adolfo-univasf/SensorBeeCounter/README.md

# SensorBeeCounter
Sensor desenvolvido para monitorar a entrada e saída de abelhas em colmeias, com o objetivo de avaliar a polinização em culturas como a manga com maior precisão.
