adolfo-univasf/SensorBeeCounter/firmware/Sensor_Firmware/Main_SensorCaixa/Esquema do prototipo.png

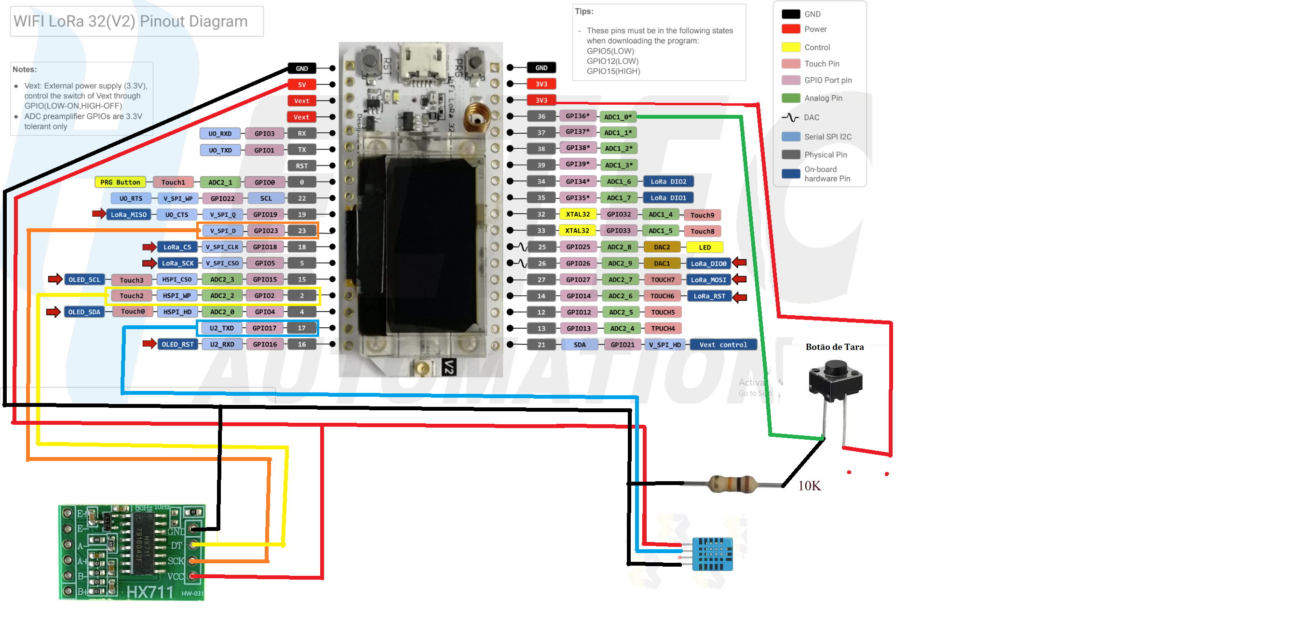
firmware/Sensor_Firmware/Main_SensorCaixa/Esquema do prototipo.png
