adolfo-univasf/SensorBeeCounter/3D_Project/Caixa Eletronica/caixa_Eletronica_KIT.FCStd

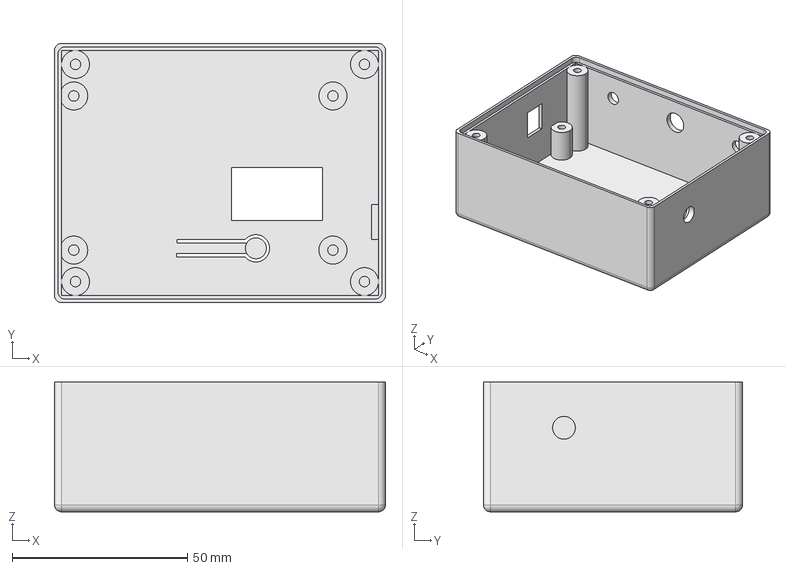
[picture p9: CAD file, 2026-01-25]
3D_Project/Caixa Eletronica/caixa_Eletronica_KIT.FCStd
94.5 x 74.0 x 37.0 mm
