adolfo-univasf/SensorBeeCounter/3D_Project/case 3d para sensor 3mm emissor 5mm/Case3D_Sensor3mm-Emissor5mm-Corpo.stl

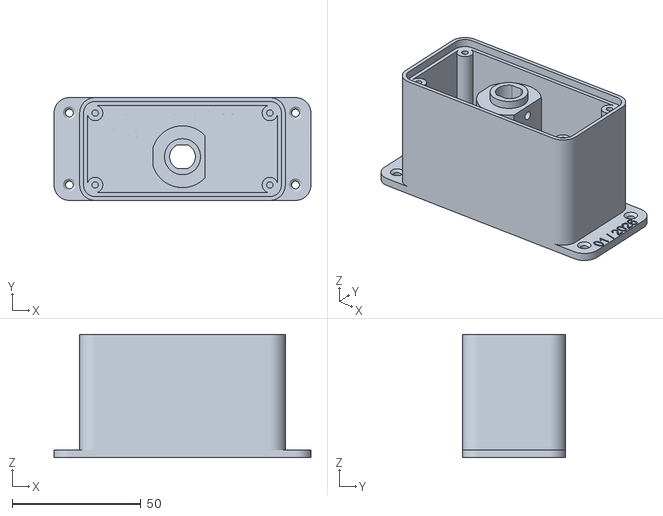
[picture p10: CAD file, 2026-01-25]
3D_Project/case 3d para sensor 3mm emissor 5mm/Case3D_Sensor3mm-Emissor5mm-Corpo.stl
100.0 x 40.0 x 48.0
