adolfo-univasf/SensorBeeCounter/3D_Project/case 3d para sensor 3mm mais preciso/Case3D_Sensor-3mm-Tampa.stl

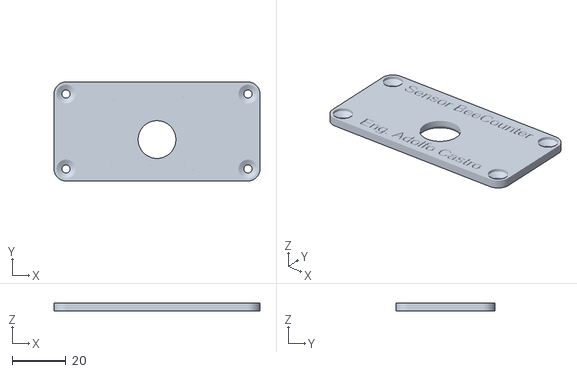
[picture p11: CAD file, 2026-01-25]
3D_Project/case 3d para sensor 3mm mais preciso/Case3D_Sensor-3mm-Tampa.stl
77.0 x 37.0 x 3.00
