adolfo-univasf/SensorBeeCounter/3D_Project/case 3d para sensor 6mm/Case3D_Sensor.FCStd

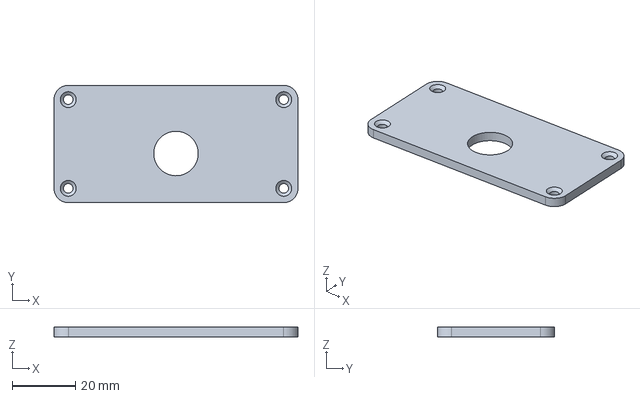
[picture p12: CAD file, 2026-01-25]
3D_Project/case 3d para sensor 6mm/Case3D_Sensor.FCStd
77.0 x 37.0 x 3.00 mm
