adolfo-univasf/SensorBeeCounter/3D_Project/Caixa Eletronica/tampa_caixaEletronica.FCStd

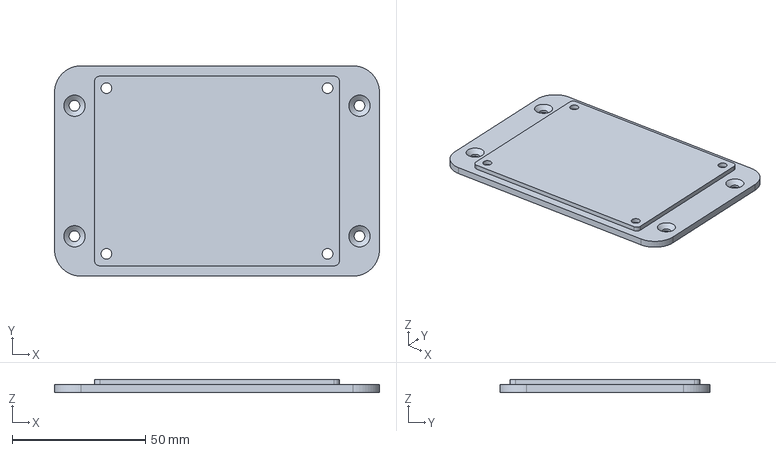
[picture p13: CAD file, 2026-01-25]
3D_Project/Caixa Eletronica/tampa_caixaEletronica.FCStd
122.0 x 79.0 x 5.00 mm
