adolfo-univasf/SensorBeeCounter/3D_Project/case 3d para sensor 6mm/Case3d.FCStd

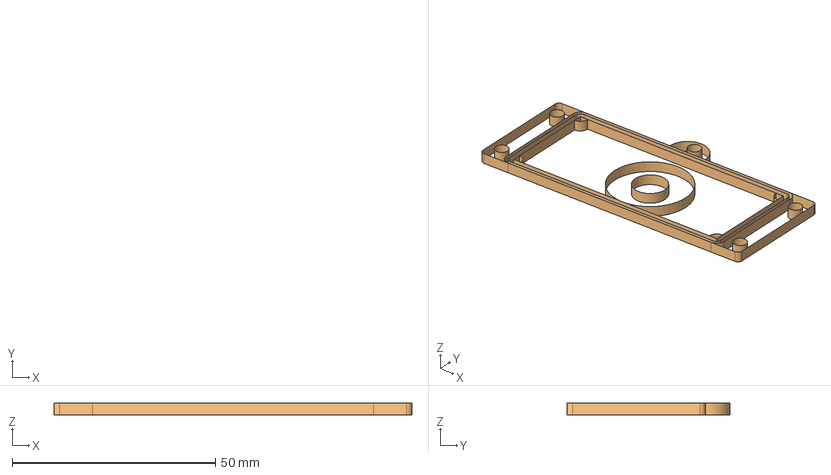
[picture p14: CAD file, 2026-01-25]
3D_Project/case 3d para sensor 6mm/Case3d.FCStd
88.0 x 40.0 x 3.00 mm
