adolfo-univasf/SensorBeeCounter/(list of files, cad)

Other CAD files:
3D_Project/case 3d para sensor 3mm emissor 5mm/Case3D_Sensor-3mm.FCStd
3D_Project/case 3d para sensor 3mm mais preciso/Case3D_Sensor-3mm-Corpo.stl
3D_Project/case 3d para sensor 6mm/Case3D_Sensor-Tampa.stl
3D_Project/case 3d para sensor 3mm mais preciso/Case3D_Sensor-3mm.FCStd
3D_Project/Caixa Eletronica/tampa_caixaEletronica.stl
3D_Project/case 3d para sensor 6mm/Case3D_Sensor.stl
