adolfo-univasf/SensorBeeCounter/Hardware/sensor.kicad_pcb

## KiCad design cpu.kicad_sch

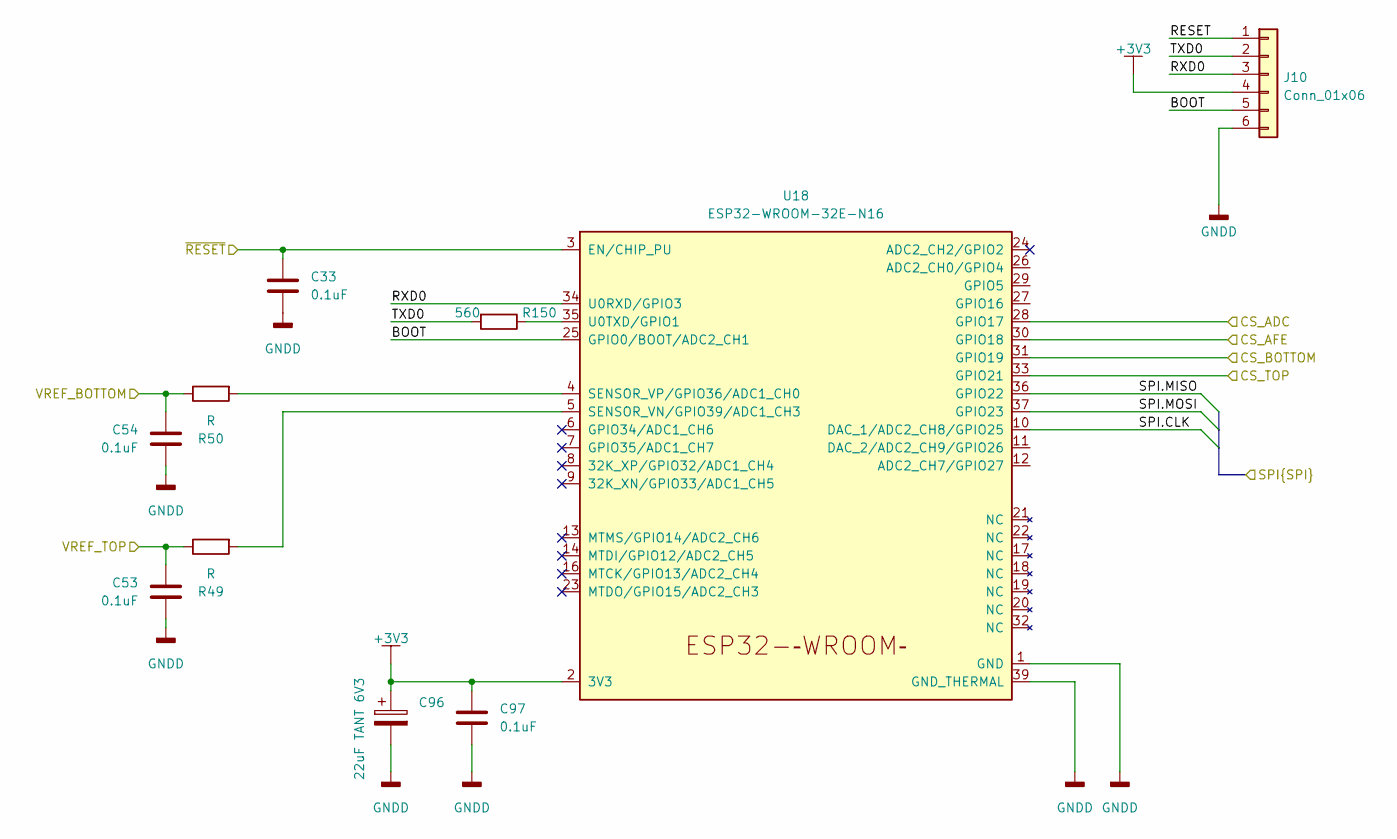
[picture p18: schematic cpu.kicad_sch]

Parts:
C33, C53, C54, C97: 0.1uF; C_0603_1608Metric
C96: 22uF TANT 6V3; CP_EIA-2012-12_Kemet-R
J10: Conn_01x06; PinHeader_1x06_P2.54mm_Vertical
R49, R50: R
R150: 560; R_0603_1608Metric
U18: ESP32-WROOM-32E-N16; ESP32-WROOM-32E

Connections:
+3V3: C96.1, C97.1, J10.4, U18.2 (3V3)
BOOT: J10.5, U18.25 (GPIO0/BOOT/ADC2_CH1)
CS_ADC: U18.28 (GPIO17)
CS_AFE: U18.30 (GPIO18)
CS_BOTTOM: U18.31 (GPIO19)
CS_TOP: U18.33 (GPIO21)
GNDD: C33.2, C53.2, C54.2, C96.2, C97.2, J10.6, U18.1 (GND), U18.15 (GND), U18.38 (GND), U18.39 (GND_THERMAL)
unnamed: R49.2, U18.5 (SENSOR_VN/GPIO39/ADC1_CH3)
unnamed: R50.2, U18.4 (SENSOR_VP/GPIO36/ADC1_CH0)
unnamed: R150.1, U18.35 (U0TXD/GPIO1)
RESET: J10.1
RXD0: J10.3, U18.34 (U0RXD/GPIO3)
SPI.CLK: U18.10 (DAC_1/ADC2_CH8/GPIO25)
SPI.MISO: U18.36 (GPIO22)
SPI.MOSI: U18.37 (GPIO23)
TXD0: J10.2, R150.2
VREF_BOTTOM: C54.1, R50.1
VREF_TOP: C53.1, R49.1
~RESET: C33.1, U18.3 (EN/CHIP_PU)
