adolfo-univasf/SensorBeeCounter/Hardware/sensor.kicad_pcb

## KiCad design engine.kicad_sch

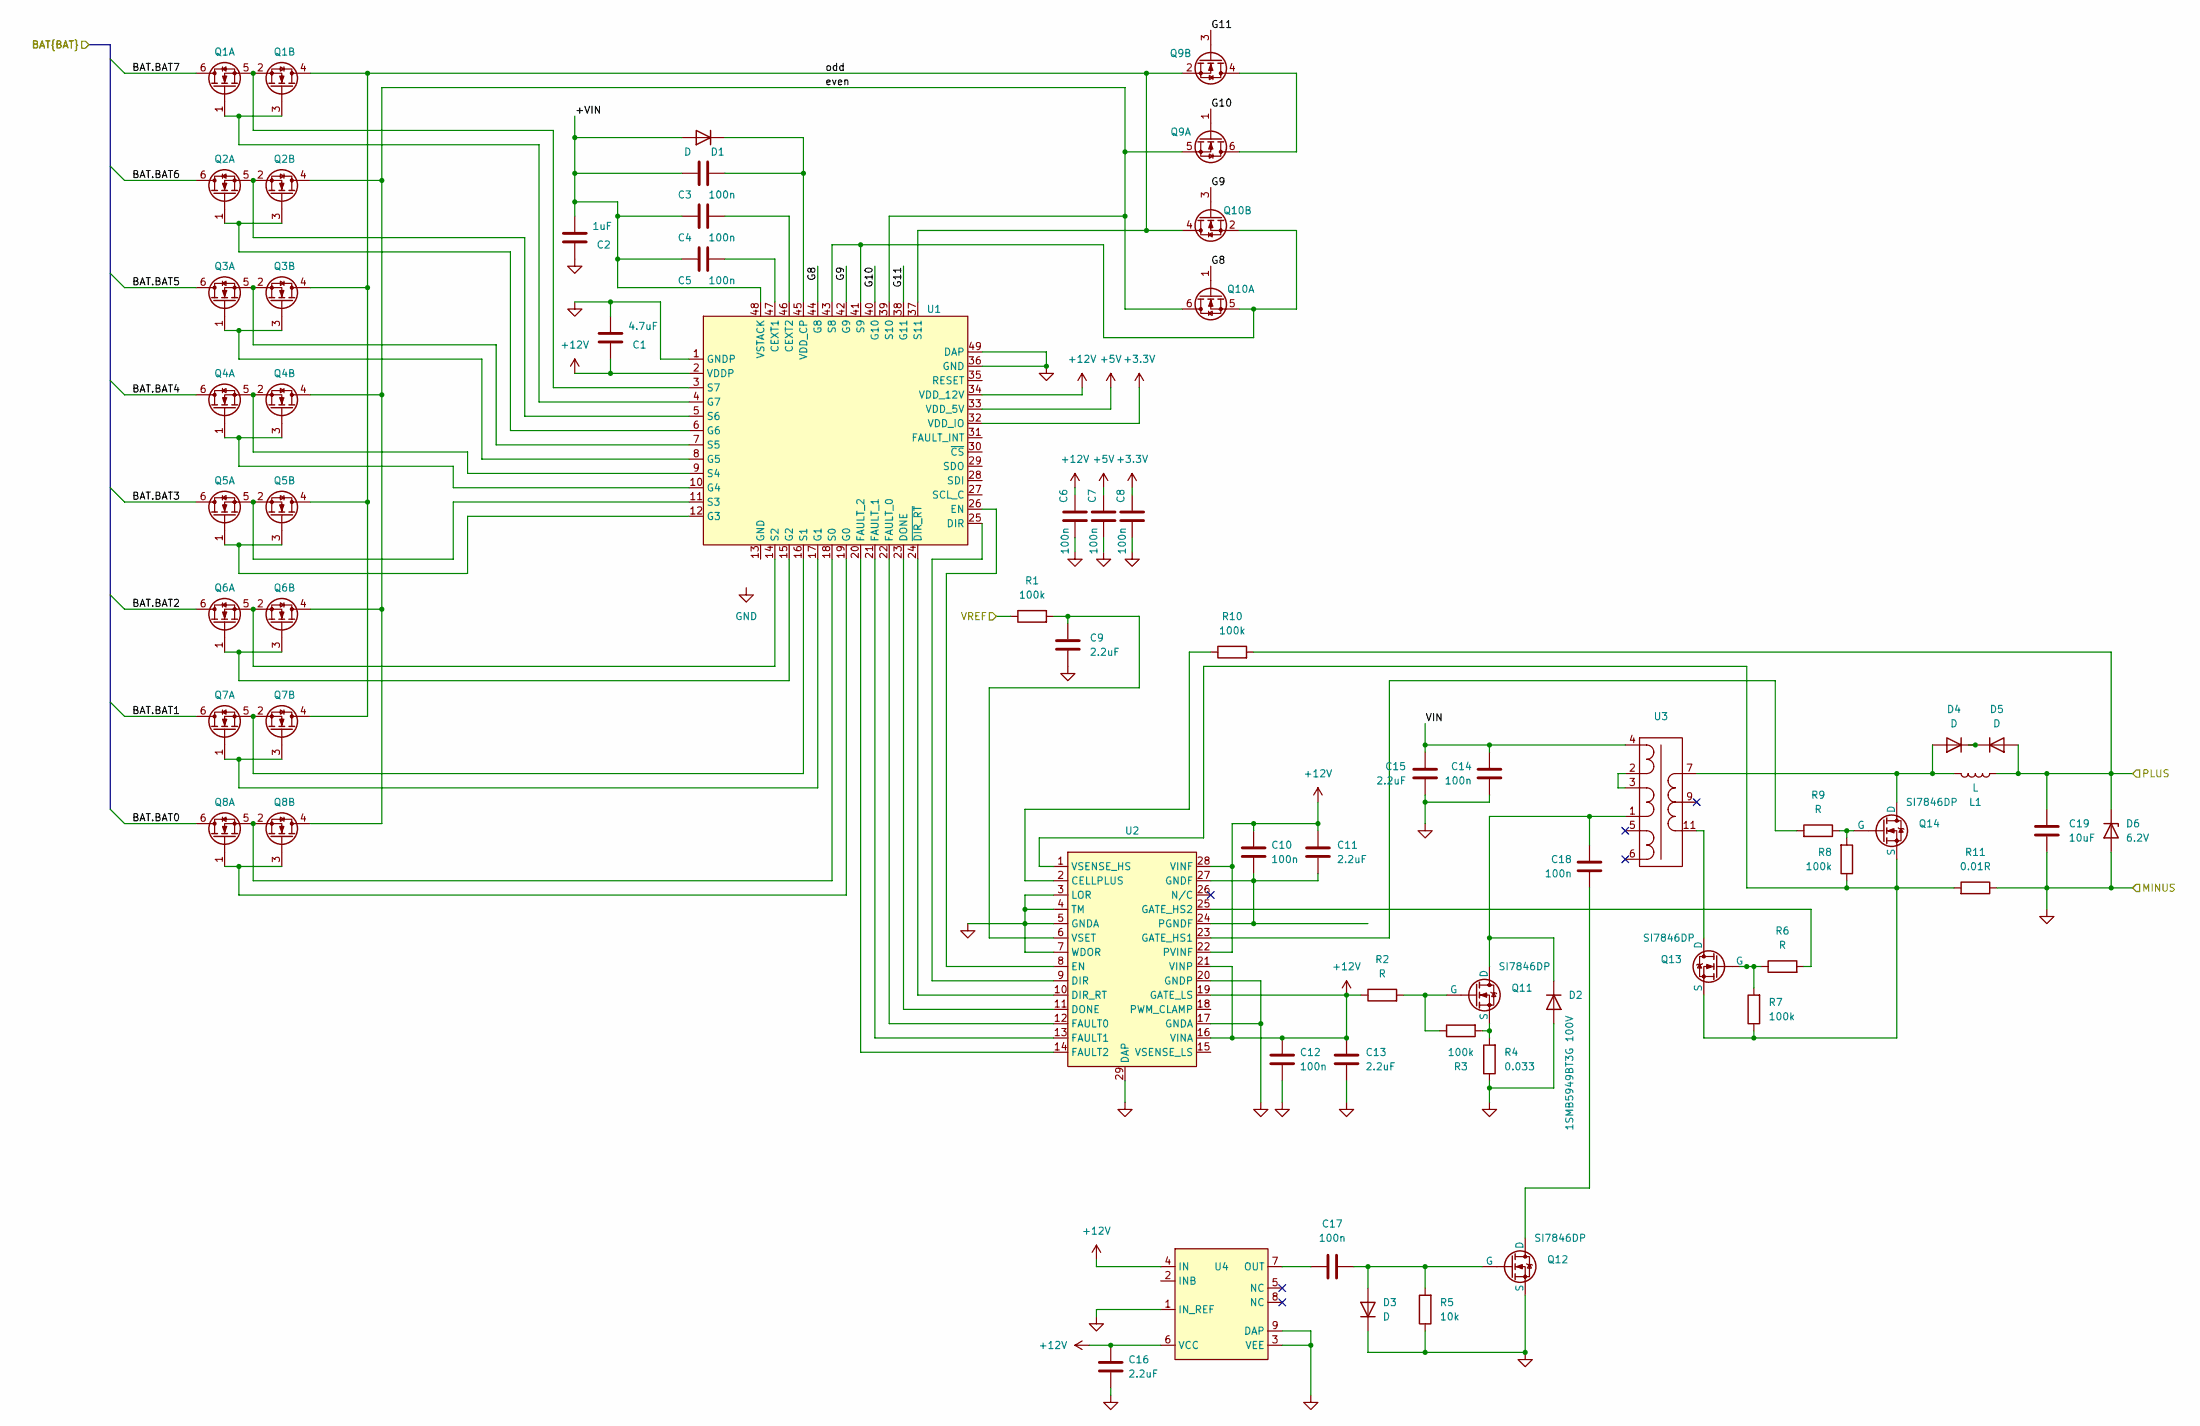
[picture p19: schematic engine.kicad_sch]

Parts:
C1: 4.7uF
C2: 1uF
C3, C4, C5, C6, C7, C8, C10, C12, C14, C17, C18: 100n
C9, C11, C13, C15, C16: 2.2uF
C19: 10uF
D1, D3, D4, D5: D
D2: 1SMB5949BT3G 100V
D6: 6.2V
L1: L
Q1, Q2, Q3, Q4, Q5, Q6, Q7, Q8, Q9, Q10: Q_Dual_NMOS_G1S2G2D2S1D1
Q11, Q12, Q13, Q14: SI7846DP
R1, R3, R7, R8, R10: 100k
R2, R6, R9: R
R4: 0.033
R5: 10k
R11: 0.01R
U1, U2, U3, U4: (no value)

Connections:
+3.3V: C8.1, U1.32 (VDD_IO)
+5V: C7.1, U1.33 (VDD_5V)
+12V: C1.2, C6.1, C10.1, C11.1, C12.1, C13.1, C16.1, R2.1, U1.2 (VDDP), U1.34 (VDD_12V), U2.16 (VINA), U2.19 (GATE_LS), U2.21 (VINP), U2.22 (PVINF), U2.28 (VINF), U4.4 (IN), U4.6 (VCC)
+VIN: C2.1, C3.1, C4.1, C5.1, D1.2 (A), U1.48 (VSTACK)
BAT.BAT0: Q8.6 (D)
BAT.BAT1: Q7.6 (D)
BAT.BAT2: Q6.6 (D)
BAT.BAT3: Q5.6 (D)
BAT.BAT4: Q4.6 (D)
BAT.BAT5: Q3.6 (D)
BAT.BAT6: Q2.6 (D)
BAT.BAT7: Q1.6 (D)
G8: Q10.1 (G), U1.44 (G8)
G9: Q10.3 (G), U1.42 (G9)
G10: Q9.1 (G), U1.40 (G10)
G11: Q9.3 (G), U1.38 (G11)
GND: C1.1, C2.2, C6.2, C7.2, C8.2, C9.2, C12.2, C13.2, C14.2, C15.2, C16.2, C19.2, D2.2 (A), D3.1 (K), D6.2 (A), Q12.3 (S), R4.1, R5.1, R11.1, U1.1 (GNDP), U1.36 (GND), U1.49 (DAP), U2.3 (LOR), U2.4 (TM), U2.5 (GNDA), U2.7 (WDOR), U2.17 (GNDA), U2.20 (GNDP), U2.29 (DAP), U4.1 (IN_REF), U4.3 (VEE), U4.9 (DAP)
unnamed: C3.2, D1.1 (K), U1.45 (VDD_CP)
unnamed: C4.2, U1.46 (CEXT2)
unnamed: C5.2, U1.47 (CEXT1)
unnamed: C9.1, R1.2, U2.6 (VSET)
unnamed: C10.2, C11.2, U2.24 (PGNDF), U2.27 (GNDF)
unnamed: C17.1, U4.7 (OUT)
unnamed: C17.2, D3.2 (A), Q12.2 (G), R5.2
unnamed: C18.1, D2.1 (K), Q11.1 (D), U3.1
unnamed: C18.2, Q12.1 (D)
unnamed: D4.1 (K), D5.1 (K)
unnamed: D4.2 (A), L1.1, Q14.1 (D), U3.7, U3.8
unnamed: Q1.1 (G), Q1.3 (G), U1.4 (G7)
unnamed: Q1.2 (S), Q1.5 (S), U1.3 (S7)
unnamed: Q2.1 (G), Q2.3 (G), U1.6 (G6)
unnamed: Q2.2 (S), Q2.5 (S), U1.5 (S6)
unnamed: Q3.1 (G), Q3.3 (G), U1.8 (G5)
unnamed: Q3.2 (S), Q3.5 (S), U1.7 (S5)
unnamed: Q4.1 (G), Q4.3 (G), U1.10 (G4)
unnamed: Q4.2 (S), Q4.5 (S), U1.9 (S4)
unnamed: Q5.1 (G), Q5.3 (G), U1.12 (G3)
unnamed: Q5.2 (S), Q5.5 (S), U1.11 (S3)
unnamed: Q6.1 (G), Q6.3 (G), U1.15 (G2)
unnamed: Q6.2 (S), Q6.5 (S), U1.14 (S2)
unnamed: Q7.1 (G), Q7.3 (G), U1.17 (G1)
unnamed: Q7.2 (S), Q7.5 (S), U1.16 (S1)
unnamed: Q8.1 (G), Q8.3 (G), U1.19 (G0)
unnamed: Q8.2 (S), Q8.5 (S), U1.18 (S0)
unnamed: Q9.4 (D), Q9.6 (D)
unnamed: Q10.2 (S), Q10.5 (S), U1.41 (S9), U1.43 (S8)
unnamed: Q11.2 (G), R2.2, R3.1
unnamed: Q11.3 (S), R3.2, R4.2
unnamed: Q13.1 (D), U3.11, U3.12
unnamed: Q13.2 (G), R6.1, R7.2
unnamed: Q13.3 (S), Q14.3 (S), R7.1, R8.1, R11.2, U2.1 (VSENSE_HS)
unnamed: Q14.2 (G), R8.2, R9.1
unnamed: R6.2, U2.25 (GATE_HS2)
unnamed: R9.2, U2.23 (GATE_HS1)
unnamed: R10.1, U2.2 (CELLPLUS)
unnamed: U1.20 (FAULT_2), U2.14 (FAULT2)
unnamed: U1.21 (FAULT_1), U2.13 (FAULT1)
unnamed: U1.22 (FAULT_0), U2.12 (FAULT0)
unnamed: U1.23 (DONE), U2.11 (DONE)
unnamed: U1.24 (~DIR_RT), U2.10 (DIR_RT)
unnamed: U1.25 (DIR), U2.9 (DIR)
unnamed: U1.26 (EN), U2.8 (EN)
unnamed: U3.2, U3.3
unnamed: U3.9, U3.10
PLUS: C19.1, D5.2 (A), D6.1 (K), L1.2, R10.2
VIN: C14.1, C15.1, U3.4
VREF: R1.1
even: Q2.4 (D), Q4.4 (D), Q6.4 (D), Q8.4 (D), Q9.5 (S), Q10.6 (D), U1.39 (S10)
odd: Q1.4 (D), Q3.4 (D), Q5.4 (D), Q7.4 (D), Q9.2 (S), Q10.4 (D), U1.37 (S11)
