adolfo-univasf/SensorBeeCounter/Hardware/sensor.kicad_pcb

## KiCad design power.kicad_sch

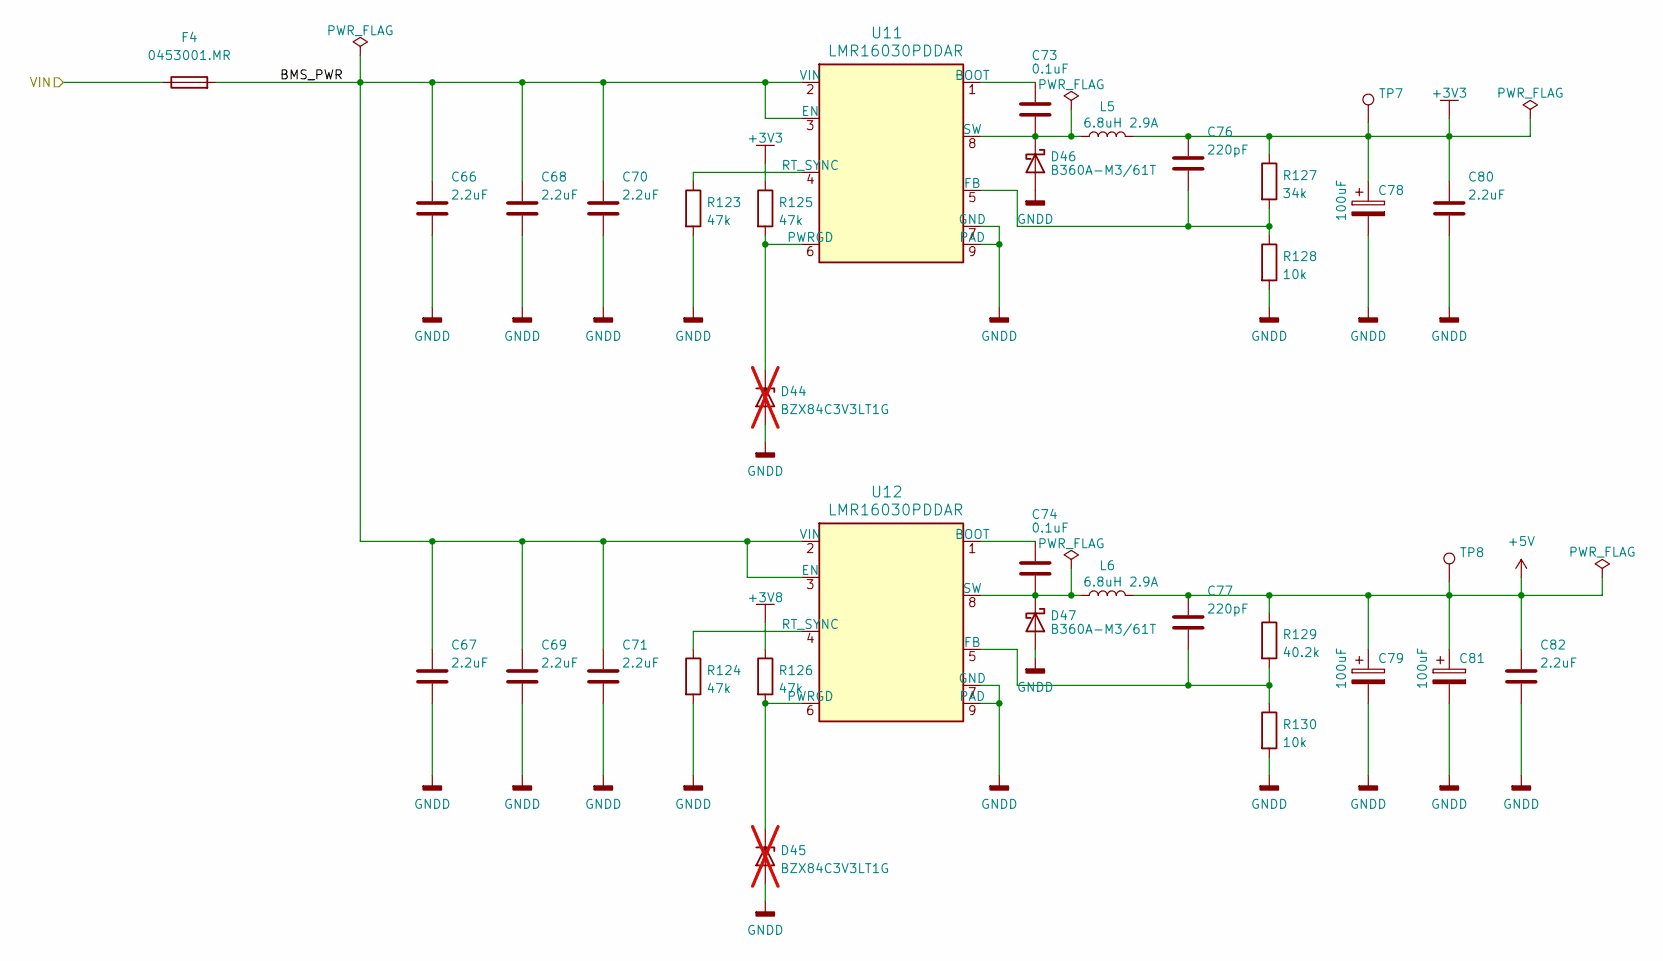
[picture p20: schematic power.kicad_sch]

Parts:
C66, C67, C68, C69, C70, C71, C80, C82: 2.2uF; C_0805_2012Metric
C73, C74: 0.1uF; C_0603_1608Metric
C76, C77: 220pF; C_0402_1005Metric
C78, C79, C81: 100uF; CP_Elec_5x5.3
D44, D45: BZX84C3V3LT1G; SOT-23; not fitted
D46, D47: B360A-M3/61T; D_SMA
F4: 0453001.MR; Fuse_2512_6332Metric
L5, L6: 6.8uH 2.9A; L_7.3x7.3_H3.5
R123, R124, R125, R126: 47k; R_0603_1608Metric
R127: 34k; R_0603_1608Metric
R128, R130: 10k; R_0603_1608Metric
R129: 40.2k; R_0603_1608Metric
TP7, TP8: TestPoint; TestPoint_Pad_D1.0mm
U11, U12: LMR16030PDDAR

Connections:
+3V3: C76.1, C78.1, C80.1, L5.2, R125.1, R127.1, TP7.1
+3V8: R126.1
+5V: C77.1, C79.1, C81.1, C82.1, L6.2, R129.1, TP8.1
BMS_PWR: C66.1, C67.1, C68.1, C69.1, C70.1, C71.1, F4.2, U11.2 (VIN), U11.3 (EN), U12.2 (VIN), U12.3 (EN)
GNDD: C66.2, C67.2, C68.2, C69.2, C70.2, C71.2, C78.2, C79.2, C80.2, C81.2, C82.2, D44.1 (A), D45.1 (A), D46.2 (A), D47.2 (A), R123.2, R124.2, R128.2, R130.2, U11.7 (GND), U11.9 (PAD), U12.7 (GND), U12.9 (PAD)
unnamed: C73.1, U11.1 (BOOT)
unnamed: C73.2, D46.1 (K), L5.1, U11.8 (SW)
unnamed: C74.1, U12.1 (BOOT)
unnamed: C74.2, D47.1 (K), L6.1, U12.8 (SW)
unnamed: C76.2, R127.2, R128.1, U11.5 (FB)
unnamed: C77.2, R129.2, R130.1, U12.5 (FB)
unnamed: D44.3 (K), R125.2, U11.6 (PWRGD)
unnamed: D45.3 (K), R126.2, U12.6 (PWRGD)
unnamed: R123.1, U11.4 (RT_SYNC)
unnamed: R124.1, U12.4 (RT_SYNC)
VIN: F4.1
