adolfo-univasf/SensorBeeCounter/firmware/Sensor_Firmware/Main_SensorCaixa/Main_SensorCaixa.ino

/*
**********************   Para não ter erro de compilação   ********************** 

Boards Manager:
-> Esp32 by Espressif Versão 2.0.14

Library:
->Heltec ESP32 Dev-Boards by Heltec Automation Versão 1.1.1

*/
//*****************************   Libraries   *****************************

#include <EEPROM.h>
#include <LittleFS.h>   // para gravar dados permanentes "mais seguro do que o SPIFFS" em relação a corromper arquivos por falta de energia
#include "FS.h"
#include <WebServer.h>
#include <Arduino.h>
#include <WiFi.h>
#include <time.h>
#include <Wire.h>
#include "RTClib.h"
#include <AsyncTCP.h>
#include <ArduinoJson.h>
#include <ESPAsyncWebServer.h>
#include "heltec.h"
#include "esp_task_wdt.h"
#include "esp_system.h"

//*****************************   Defines   *****************************

//#define BAND    915E6  //Escolha a frequência radio lora  868-915MHz
#define BAND    90973E4 // (868 a 909,7) - 909,73MHz - (909,76 - 915)    faixa de 30 khz para não ter interferencia 
#define Pin_ADC_Bateria 13
#define Pin_Sensor_DTH 17
#define LED2 25
#define calibrar false  // coloque true quando quiser calibrar

//*****************************   Configurações Wifi e Web   *****************************

AsyncWebServer server(80);
//WebServer server(80); // estatico
#define SSID "JRTELECOMADOLFO" // Your WiFi SSID
#define PASSWORD "38632391"    // Your WiFi Password
const char* AP_SSID = "BeeCounter";
const char* AP_PASSWORD = "12345678";
IPAddress local_IP(192, 168, 4, 1);
IPAddress gateway(192, 168, 4, 1);
IPAddress subnet(255, 255, 255, 0);
bool wifiLigado = false;
unsigned long wifiStartTime = 0;


//*****************************   Definiçoes de Tempo   *****************************

#define WDT_TIMEOUT 360   // wachdog 6 minutos (em segundos)
#define WIFI_TIMEOUT 900000   // 15 minutos para desligar o wifi (15 * 60 * 1000) = 900000 milissegundos
const unsigned long TIMEOUT_FSM = 5000; // 5 segundos
const unsigned long Time_Display = 30000; // 30s
unsigned long tempo_salvarDados = 300; // 5min *60 = 300 segundos  Tempo em que o timer é configurado para armazenar os dados no arquivo csv


//*****************************   Estados dos sensores (bitmask)   *****************************
#define WAIT        0b111  // repouso
#define STATE_3     0b110  // S3 foi o primeiro sensor
#define STATE_2     0b101  // S2 já aconteceu (independente do estado atual)
#define STATE_2_3   0b100  // sensor 2 e 3 acionado
#define STATE_1     0b011  // S1 foi o primeiro sensor
#define STATE_1_3   0b010  // sensor 1 e 3 acionado
#define STATE_1_2   0b001  // sensor 1 e 2 acionado
#define STATE_1_2_3 0b000  // sensor 1, 2 e 3 acionado

RTC_DS3231 rtc; // modulo rtc
TwoWire I2C_RTC = TwoWire(1); // I2C secundário (isolado)

enum EstadoFSM 
{
  FSM_IDLE,        // aguardando início (111)
  FSM_S1_SEEN,     // S1 já foi visto
  FSM_S3_SEEN,     // S3 já foi visto
  FSM_S1_S2_SEEN,  // S1 e S2 já foram vistos
  FSM_S3_S2_SEEN,   // S3 e S2 já foram vistos
  FSM_ALL_SEEN,     // os 3 sensores já ocorreram
  FSM_RETURN
};

enum Sentido 
{
  ENTRADA = 0,
  SAIDA   = 1
};

//*****************************   Variaveis Externas   *****************************

extern const char PAGE_HTML[] PROGMEM; // HTML web page
extern const char PAGE_FILE_NOT_FOUND[] PROGMEM;
extern String processor(const String& var);
extern void Setup_Server();
extern const char* PARAM_STRING; // WEB

//*****************************   Constantes   *****************************

const char* PARAM_INT   = "inputInt";
const char* PARAM_FLOAT = "inputFloat";
const int calVal_eepromAdress = 0;

//******   PINOUT INPUTS   ****** 
const int S1 = 23; //mcu > este pino deve estar em low ao fazer o downloading do programa
const int S2 = 2; 
const int S3 = 17; 
const int button_WakeUp = 36;
const int botao_Configurar = 37;
const int Adc_Battery = 38; //mcu > este pino deve estar somente como entrada

// RTC usa os pinos por padrão DS3231
//SCL -> GPIO22 
//SDA -> GPIO21

//******   PINOUT OUTPUTS   ****** 
const int SaidaVext = 21; // Vext: External power supply (3,3v), control the switch of Vext through GPIO (LOW -> ON , HIGH -> OFF)   

// *****************************   Variables Global   *****************************

unsigned int EntradasBuffer = 0,
             SaidasBuffer = 0,
             ReturnHiveBuffer = 0,   // retorna para a colmeia
             ReturnFieldBuffer = 0;  // retorna para o campo
String Bateria = "0.0",Erros = "",DadosAtuaisLora = "";
String packSize = "--";
hw_timer_t * Timer_SalvarDados = NULL; // temporizador
volatile bool Flag_tempo_SalvarDados = false;
uint8_t state_Sensors= 0;
bool Flag_Sensors = false;
bool State_button_WakeUp = true; // Button to ON Display
unsigned long time_DisplayON= 0; // time the display is ON
unsigned long TempoUltimoDadoSalvo = 0;
unsigned long t = 0;
String packet, ip_server ;
float currentBateria;
EstadoFSM estadoFSM = FSM_IDLE;
Sentido sentidoFSM;
unsigned long tempoEstado = 0;
int Quant_timeout_state2 = 0;
//String IDcaixa;  
int packetSize = LoRa.parsePacket();

const String ID_Sensor = "Sensor_1";   // ID do Sistema embarcado, ele irá determinar o nome dos arquivos salvos e comunicação lora

/*********************   Protótipos das funções **********************/
void sendPacket();
void IRAM_ATTR InterruptExternSensors();
void processaFSM(uint8_t estado);
void registraEvento(uint8_t ultimoEstadoFSM);
void printEstadoSensores(uint8_t estado);
String ReadtimeRTC(char tipo);
uint8_t ReadingSensors();
void ReadButtonDisplay();
String ReadBattery();
void handleFileDownload(AsyncWebServerRequest *request);
String formatarTamanho(size_t bytes);
void SalvarDadosEmArquivo();
void DeleteDadosAtuais();
void UpdateWeb();
String processor(const String& var);
void watchdogSetup();
void EscutaGateway(int packetSize);


/*********************   Interrupção timer **********************/

void IRAM_ATTR Ativa_Flag_tempo_SalvarDados()   //função de envio quando a interrupção é chamada
{
  Flag_tempo_SalvarDados = true;
}




/******************* função principal (setup) *********************/
void setup()
{
  setCpuFrequencyMhz(80);  // 240Mhz = 140mA,   160Mhz = 119mA,  80Mhz = 105mA

  pinMode(button_WakeUp,INPUT);
  pinMode(S1,INPUT);
  pinMode(S2,INPUT);
  pinMode(S3,INPUT);
  pinMode(SaidaVext,OUTPUT);
  pinMode(botao_Configurar,INPUT);

  analogReadResolution(12); // Define a resolução (9-12 bits).
  analogSetAttenuation(ADC_11db); // Define a faixa de tensão. 

 //*********************   Interrupção externa para os 3 sensores   **********************
  attachInterrupt(S1, InterruptExternSensors, CHANGE);
  attachInterrupt(S2, InterruptExternSensors, CHANGE);
  attachInterrupt(S3, InterruptExternSensors, CHANGE);

 //*********************   Timer para salvar dados no arquivo csv   **********************
  Timer_SalvarDados = timerBegin(1, 80, true); // ( numero do temporizador utilizado no esp tem de 0 a 3, prescaler, e o último é um sinalizador indicando se o contador deve contar para cima (verdadeiro) ou para baixo (falso) )
  timerAttachInterrupt(Timer_SalvarDados, &Ativa_Flag_tempo_SalvarDados, true);
  timerAlarmWrite(Timer_SalvarDados, tempo_salvarDados*1000000, true); // 1000000 microssegundos = 1 segundo, Para o terceiro argumento, passaremos o valor true, assim o contador irá recarregar e assim a interrupção será gerada periodicamente.
  timerAlarmEnable(Timer_SalvarDados);

  int cont =0;

  delay(500);
  Serial.println("************************   Inicializando Display   ************************  ");
  delay(500);
  Heltec.begin(true /*Habilita o Display*/, true /*Heltec.Heltec.Heltec.LoRa Disable*/, true /*Habilita debug Serial*/, true /*Habilita o PABOOST*/, BAND /*Frequência BAND*/);
  displaySetup();
  delay(500);

  Serial.begin(115200);  
  delay(500);
  
  Serial.flush();

  // I2C do RTC isolado
  I2C_RTC.begin(13, 22, 100000); // SDA, SCL, 100kHz

  digitalWrite(SaidaVext,LOW);
    delay(500);
  Serial.println("************************   Scan barramento I2C Secundario    ************************   ");
  for (byte addr = 1; addr < 127; addr++) 
  {
    I2C_RTC.beginTransmission(addr);
    if (I2C_RTC.endTransmission() == 0) 
    {
      Serial.print("Encontrado em 0x");
      Serial.println(addr, HEX);
    }
    delay(10);
  }

  // inicializando modulo rtc
  Serial.flush();
  Serial.println("************************   Inicializando modulo RTC   ************************  ");
  delay(100);

  if (!rtc.begin(&I2C_RTC)) 
  {
    Serial.println(" RTC nao encontrado ");
  } else {
    Serial.println(" RTC OK");
    DateTime now = rtc.now();
    Serial.println(now.timestamp(DateTime::TIMESTAMP_FULL));
  }
  if (rtc.lostPower()) {
    Serial.println("RTC lost power, let's set the time!");
    rtc.adjust(DateTime(2026, 2, 11, 8, 32, 0)); //     11/02/2026  8h:32 min
    Erros += " RTC_lost_power";
  }

  BeginLittleFS();
  watchdogSetup();

  //***********************************************   Configurações parametro Radio lora  ***********************************************

  //LoRa.setTxPower(20); // Define a potência de transmissão. Valores típicos: 2 a 20 dBm, 20 dBm = potência máxima (usa PA_BOOST).       
  LoRa.setTxPower(20, RF_PACONFIG_PASELECT_PABOOST); //    
  LoRa.setSpreadingFactor(12); // Define o Spreading Factor (SF7 a SF12). SF7  = maior taxa de dados, menor alcance. SF12 = menor taxa de dados, maior alcance e sensibilidade.  Impacta diretamente no tempo no ar (Time On Air).   
  LoRa.setSignalBandwidth(250E3); // Define a largura de banda do sinal (Bandwidth). Valores comuns: 125E3, 250E3, 500E3.
  // Banda menor → maior sensibilidade e alcance.
  // Banda maior → maior velocidade de transmissão.
  LoRa.setCodingRate4(5); // Define o Coding Rate (taxa de correção de erro). Parâmetro 5 a 8 representa 4/5 até 4/8. Quanto maior o número, maior a redundância e robustez, porém menor a taxa útil de dados.       
  LoRa.setPreambleLength(8); // Define o tamanho do preâmbulo. O preâmbulo é usado para sincronização entre transmissor e receptor. Valores maiores aumentam confiabilidade em links longos, mas aumentam o tempo no ar.    
  LoRa.enableCrc(); // Habilita verificação CRC no payload. Garante detecção de erros no pacote recebido. Recomendado manter ativado.             
  //LoRa.setSyncWord(0x34); // Define o Sync Word. Funciona como "identificador de rede". Dispositivos só recebem pacotes com o mesmo Sync Word. 0x34 é comum para uso privado (LoRa ponto-a-ponto).
  
}



void loop()
{
  if (Flag_Sensors == true){
    Flag_Sensors = false;
    state_Sensors = ReadingSensors();
    processaFSM(state_Sensors);
  }

 ReadButtonDisplay();// rotina para verificar se botão wake up foi pressionado, se sim liga o wifi e gera a pagina web para download dos dados

 if (Flag_tempo_SalvarDados == true){
  Flag_tempo_SalvarDados = false;
  SalvarDadosEmArquivo();
 }
  EscutaGateway(packetSize);
}


// *********  Functions   *********

void SalvarDadosEmArquivo(){

  // O espaço maximo é de 1,5Mbytes, então fica 768kB para dados e 768kb para o backup
  //int TamanhoMaximoArquivo = 750; // Tamanho maximo para o arquivo de dados, 750kb para ficar 18kb de folga
  float TamanhoMaximoArquivo = 750, TamanhoArquivo; 
  String DadosAtuais,
         Entradas,
         Saidas,
         ReturnHive,   // retorna para a colmeia
         ReturnField;  // retorna para o campo


  String Arquivo = "", Arquivo_backup = "";

  Arquivo = "/" + ID_Sensor + "_Dados.csv";
  Arquivo_backup = "/" + ID_Sensor + "_Backup_Dados.csv";



  esp_task_wdt_reset();   // Alimenta o watchdog

  Serial.println("Temporizador de salvar dados no arquivo ativado\n");
  Serial.print("Intervalo entre a ultimo armazenamento: ");
  Serial.print((millis() - TempoUltimoDadoSalvo)/1000);
  Serial.println(" segundos");
  TempoUltimoDadoSalvo = millis();
  listDir(LittleFS, "/", 1); // List the directories up to one level beginning at the root directory
  // "Data, Entradas, Saidas, Bateria, Erros"
  //appendFile(LittleFS, "/Dados.csv", "Data, Entradas, Saidas, Bateria, Erros\r\n"); //Append some text to the previous file
  DadosAtuais = "";
  DadosAtuais = ReadtimeRTC('D'); // Data
  DadosAtuais +=  ",";
  DadosAtuais += ReadtimeRTC('H'); // Hora
  DadosAtuais +=  ",";
  DadosAtuais += String(EntradasBuffer); // Entradas
  DadosAtuais +=  ",";
  DadosAtuais += String(SaidasBuffer); // Saidas
  DadosAtuais +=  ",";
  Bateria = ReadBattery(); // Tensão da bateria
  DadosAtuais += Bateria; // Tensão da bateria
  DadosAtuais +=  ",";
  DadosAtuais +=  Erros;
  DadosAtuais += "\r\n"; // Erros
  DadosAtuaisLora = DadosAtuais;


  Serial.println("********************************************");
  Serial.println("Dados:");
  Serial.println(DadosAtuais);
  Serial.println("Dados:");
  Serial.println(DadosAtuaisLora);
  Serial.println("********************************************");


  if(!FileExiste(LittleFS, Arquivo.c_str()))  // Se o arquivo Não existir, cria o arquivo e imprime o cabeçalho
  { 
    //writeFile(LittleFS, "/Dados.csv", "Data (TimeStamp), Entradas, Saidas, Bateria (Volts), Falhas\r\n");
    writeFile(LittleFS, Arquivo.c_str(), "Data (DD/MM/YY),Hora (hh:mm:ss),Entradas,Saidas,Bateria (Volts),Falhas\r\n");
    appendFile(LittleFS, Arquivo.c_str(), DadosAtuais.c_str()); //Append some text to the previous file
    DeleteDadosAtuais();
  }else{
  
    TamanhoArquivo = sizeFile(LittleFS, Arquivo.c_str());

    if(TamanhoArquivo > TamanhoMaximoArquivo){ // Se o arquivo Dados for maior que 1MB, cria um backup e apaga o antigo backup
     
      Serial.print("\nO arquivo Dados é Maior que ");Serial.print(TamanhoMaximoArquivo);Serial.print(" kByte \n Tamanho Arquivo Dados: ");
      Serial.print(TamanhoArquivo);
      Serial.print(" kBytes\n");

      if(!FileExiste(LittleFS, Arquivo_backup.c_str())){ // Se o backup não existir, o arquivo dados será transformado em backup
      
        renameFile(LittleFS, Arquivo.c_str(), Arquivo_backup.c_str()); 
        //writeFile(LittleFS, "/Dados.csv", "Data (TimeStamp), Entradas, Saidas, Bateria (Volts), Falhas \r\n");
        writeFile(LittleFS, Arquivo.c_str(), "Data (DD/MM/YY),Hora (hh:mm:ss),Entradas,Saidas,Bateria (Volts),Falhas\r\n");
        appendFile(LittleFS, Arquivo.c_str(), DadosAtuais.c_str());
        DeleteDadosAtuais();
      }else{ // Se o backup existir, o backup antigo será deletado e o arquivo dados será transformado em backup
      
        deleteFile(LittleFS, Arquivo_backup.c_str());
        renameFile(LittleFS, Arquivo.c_str(), Arquivo_backup.c_str()); // Se o arquivo ficar maior que 1Mbyte será criado um backup (evitar ficar manipulando arquivos muito grandes)
        writeFile(LittleFS, Arquivo.c_str(), "Data (DD/MM/YY),Hora (hh:mm:ss),Entradas,Saidas,Bateria (Volts),Falhas\r\n");
        appendFile(LittleFS, Arquivo.c_str(), DadosAtuais.c_str());
        DeleteDadosAtuais();
      }

    }else{
      Serial.print("\nO arquivo Dados é Menor que ");Serial.print(TamanhoMaximoArquivo);Serial.print(" kByte \n Tamanho Arquivo Dados: ");
      Serial.print(TamanhoArquivo);
      Serial.print(" kBytes\n");
      appendFile(LittleFS, Arquivo.c_str(), DadosAtuais.c_str());
      DeleteDadosAtuais();

      Serial.println(LittleFS.totalBytes()); // Total de Bytes na partição LittleFS
      Serial.println(LittleFS.usedBytes());  // Total de Bytes usados
    }
  }







}

void DeleteDadosAtuais(){
  EntradasBuffer = 0;
  SaidasBuffer = 0;
  ReturnHiveBuffer = 0;   // retorna para a colmeia
  ReturnFieldBuffer = 0;  // retorna para o campo
  Erros = "";
}

void ReadButtonDisplay(){
  if (digitalRead(button_WakeUp) == HIGH)
  {

    State_button_WakeUp = true;
    time_DisplayON = millis();
    Heltec.display->displayOn();
    Serial.println("");
    Serial.print(" Entradas: ");
    Serial.print(EntradasBuffer);
    Serial.println("");
    Serial.print(" Saidas: ");
    Serial.print(SaidasBuffer);
    Serial.println("");
    Serial.print(" ReturnHiveBuffer: ");
    Serial.print(ReturnHiveBuffer);
    Serial.println("");
    Serial.print(" ReturnFieldBuffer: ");
    Serial.print(ReturnFieldBuffer);
    Serial.println("");
    Serial.print(ReadBattery());
    Serial.println("");


    if (!wifiLigado) 
    {
      char cont = 3;
      delay(30); // debounce
      Serial.println("\nIniciando WiFi...");
      WiFi.mode(WIFI_AP);
      while(!WiFi.softAPConfig(local_IP, gateway, subnet) && (cont > 0)){
        Serial.println("Falha ao configurar IP fixo!");
        display_WiFi_Failed(cont);
        cont--;
      }
      WiFi.softAP(AP_SSID, AP_PASSWORD);
      Serial.println("WiFi AP iniciado!");
      Serial.print("IP do ESP32: ");
      Serial.println(WiFi.softAPIP());
      display_Wifi_OK();
      wifiLigado = true;
      wifiStartTime = millis();
      UpdateWeb(); // Página principal
    }
  }

  // desliga após 30 segundos
  if (State_button_WakeUp && ((millis() - time_DisplayON) >= Time_Display)) {
    State_button_WakeUp = false;
    Heltec.display->displayOff();
  }

  // 🔹 Desliga WiFi após 30 minutos
  if (wifiLigado && (millis() - wifiStartTime >= WIFI_TIMEOUT)) {
    Serial.println("\nTempo expirado! Desligando WiFi...");
    WiFi.softAPdisconnect(true);
    WiFi.mode(WIFI_OFF);
    wifiLigado = false;
    displayDesligandoWifi();
  }
}

uint8_t ReadingSensors(){
  return(digitalRead(S1)<< 0) | (digitalRead(S2)<< 1) | (digitalRead(S3)<< 2);
}

String ReadtimeRTC(char tipo){
  /*
    D -> `DD/MM/YY`
    H -> `hh:mm`
    F -> `YYYY-MM-DDThh:mm:ss`
    T -> '1767602334'    formato timeStamp
  */
   digitalWrite(SaidaVext,LOW); 
   if (!rtc.begin(&I2C_RTC)){
     Serial.println(" RTC nao encontrado ");
     return "NULL";
   }
   String Data = "";
   DateTime now = rtc.now();
   
   switch (tipo){
    case 'D':
      Data = String(now.day());
      Data += "/";
      Data += String(now.month());
      Data += "/";
      
      if(now.year() > 2000)
        Data += String(now.year()-2000);
      else
        Data += String(now.year());
      digitalWrite(SaidaVext,HIGH); //Desliga o modulo RTC3132 para economizar consumo
      break;
    case 'H':
      Data = now.timestamp(DateTime::TIMESTAMP_TIME); // `hh:mm:ss`
      digitalWrite(SaidaVext,HIGH); //Desliga o modulo RTC3132 para economizar consumo
      break;
    case 'F':
      Data = String(now.timestamp(DateTime::TIMESTAMP_FULL)); //!< `YYYY-MM-DDThh:mm:ss`
      break;
    default:
      Data = String(now.unixtime()); // Retorna a data no formato timestamp Unix de  0 até 4.294.967.295 segundos
   }
   return Data;
}

void IRAM_ATTR InterruptExternSensors(){
  Flag_Sensors = true;
}

String ReadBattery(){
  float tensao = 0.0, mediana, calibracao = 1.134;
  unsigned int Ad[10], min, aux;
  char cont = 0, cont2 = 0;

  // Coleta das tensões
  for(cont=0;cont<10;cont++) {
    Ad[cont]= analogRead(Adc_Battery);
    delay(50);
  }

  // Ordenação do vetor de leituras (Selection Sort)
  Serial.println("\nVetor de leituras ordenado:\n");
  Serial.print("| ");
  for(cont = 0;cont < 9;cont++){
    min = cont;
    for(cont2 = cont + 1; cont2 < 10; cont2++){
      if(Ad[cont2] < Ad[min]){
        min = cont2;
      }
    }

    aux = Ad[cont];
    Ad[cont] = Ad[min];
    Ad[min] = aux;

    Serial.print(Ad[cont]);
    Serial.print(" | ");

  }
  Serial.print(Ad[9]);
  Serial.print(" | ");
  Serial.println("\nMediana: ");
  mediana = (Ad[4]+Ad[5]) / 2.0 ;
  Serial.print(mediana);
  Serial.println("");
  Serial.print("\ntensao: ");

  /*
   (0-3.3V) em valores digitais de 0 a 4095 (2^12)
    4096 -> 3,3v  Resolução = 0,8056640625mV  0,00080566
    Vout = mediana * 0.0008056640625
    
    Divisor de tensão R1 = 222k, R2 = 22k
    Vout = Vin*R2/(R1+R2) -> Vin = Vout*(R1+R2)/R2
    Vin = Vout*(222k+22k)/22k -> Vin = Vout*11

    Queda de tensão do diodo medida em bancada = 0,63v, então será tensão medida + 0,63v = tensão da bateria

    vout = mediana * 0,00080566 

    vin = (mediana * 0.0008056640625)*11 + 0.63
    vin = mediana * 0,0088623046875 + 0,63
    
    calibração para chegar a tensão medida = 1,125
      medidas em bancada
      multimetro =  1,0888v, tensão adc = 0,96v
      calibração = 1,088/0,96 = 1,134
  */
  Serial.println("ADC: ");
  Serial.print(mediana * 0.0008056640625 * calibracao);
  Serial.println("");
  if(mediana < 0.5) // evita a correção de 0,63v da queda do diodo se a tensão zerar
    tensao = 0.0;
  else
    //tensao = (mediana * 0.00894287109375 * calibracao) + 0.63; // 0 a 3,3v
    tensao = (mediana * 0.0088623046875 * calibracao) + 0.63; // 0 a 3,3v

  return String(tensao,1); // retorna apenas com uma casa decimal
}


void watchdogSetup(){

  /************** Essa struct só existe no Core 2.x (IDF 4.4+). *********************/
  
  esp_task_wdt_init(WDT_TIMEOUT, true);  // timeout em segundos
  esp_task_wdt_add(NULL);                // adiciona a task principal

  /************** Verifica o motivo do ultimo reset *********************/
  /*
    0  - ESP_RST_UNKNOWN,    //!< Reset reason can not be determined
    1  - ESP_RST_POWERON,    //!< Reset due to power-on event
    2  - ESP_RST_EXT,        //!< Reset by external pin (not applicable for ESP32)
    3  - ESP_RST_SW,         //!< Software reset via esp_restart
    4  - ESP_RST_PANIC,      //!< Software reset due to exception/panic
    5  - ESP_RST_INT_WDT,    //!< Reset (software or hardware) due to interrupt watchdog
    6  - ESP_RST_TASK_WDT,   //!< Reset due to task watchdog
    7  - ESP_RST_WDT,        //!< Reset due to other watchdogs
    8  - ESP_RST_DEEPSLEEP,  //!< Reset after exiting deep sleep mode
    9  - ESP_RST_BROWNOUT,   //!< Brownout reset (software or hardware)
    10 - ESP_RST_SDIO,       //!< Reset over SDIO
    */
  esp_reset_reason_t motivo = esp_reset_reason();
  switch (motivo){
    case 0:
      Erros = "RST_Unknown"; // Salva na historico o motivo do resete
      break;
    case 4:
      Erros = "RST_Panic"; // Salva na historico o motivo do resete
      break;
    case 6:
      Erros = "RST_Wachdog_Task"; // Salva na historico o motivo do resete
      break;
    case 7:
      Erros = "RST_Wachdog"; // Salva na historico o motivo do resete
      break;
    default:  
    Erros = "";
    break;
  } 
  Serial.println("**************** Erros ***************\n");
  Serial.println(Erros);
  Serial.println("**************************************");
}
