adolfo-univasf/SensorBeeCounter/firmware/Sensor_Firmware/Main_SensorCaixa/web/Web_Back_End.ino

// *********   variaveis externas   *********

extern const char* PARAM_STRING = "ID_Caixa";  //web
extern const char index_html[] PROGMEM; // HTML web page

//***************************   prototipo da função   ***************************

void notFound(AsyncWebServerRequest *request);
void writeFile(fs::FS &fs, const char * path, const char * message);
String readFile(fs::FS &fs, const char * path);
String processor(const String& var);
void Setup_Server(); 

//***************************   funções   ***************************

void notFound(AsyncWebServerRequest *request) {
  request->send(404, "text/plain", "Not found");
}

String readFile(fs::FS &fs, const char * path){
  Serial.printf("Reading file: %s\r\n", path);
  File file = fs.open(path, "r");
  if(!file || file.isDirectory())
  {
    Serial.println("- empty file or failed to open file");
    
    return String();
    delay(2000);
  }
  Serial.println("- read from file:");
  String fileContent;
  while(file.available()){
    fileContent+=String((char)file.read());
  }
  file.close();
  Serial.println(fileContent);
  return fileContent;
}

void writeFile(fs::FS &fs, const char * path, const char * message){
  Serial.printf("Writing file: %s\r\n", path);
  File file = fs.open(path, "w");
  if(!file){
    Serial.println("- failed to open file for writing");
    return;
  }
  if(file.print(message)){
    Serial.println("- file written");
  } else {
    Serial.println("- write failed");
  }
  file.close();
}

// Replaces placeholder with stored values
String processor(const String& var){
  //Serial.println(var);

  if(var == "ID_Caixa");
    return readFile(SPIFFS, "/ID_Caixa.txt");


  /*
  if(var == "inputString"){
    return "ola";
    //return readFile(SPIFFS, "/inputString.txt");
  }
  else if(var == "inputInt"){
    return readFile(SPIFFS, "/inputInt.txt");
  }
  else if(var == "inputFloat"){
    return readFile(SPIFFS, "/inputFloat.txt");
  }
  */
  return String();
}

void Setup_Server(){


  // Initialize SPIFFS
  if(!SPIFFS.begin(true)){
    Serial.println("An Error has occurred while mounting SPIFFS");
    return;
  }

  // Send web page with input fields to client
  server.on("/", HTTP_GET, [](AsyncWebServerRequest *request){
    request->send_P(200, "text/html", index_html, processor);
  });

  // Send a GET request to <ESP_IP>/get?inputString=<inputMessage>
  server.on("/get", HTTP_GET, [] (AsyncWebServerRequest *request) 
  {
    String inputMessage;
    
    // GET inputString value on <ESP_IP>/get?inputString=<inputMessage>
    if (request->hasParam(PARAM_STRING)) {
      inputMessage = request->getParam(PARAM_STRING)->value();
      writeFile(SPIFFS, "/ID_Caixa.txt", inputMessage.c_str());
    }

    /*
    // GET inputString value on <ESP_IP>/get?inputString=<inputMessage>
    if (request->hasParam(PARAM_STRING)) {
      inputMessage = request->getParam(PARAM_STRING)->value();
      writeFile(SPIFFS, "/inputString.txt", inputMessage.c_str());
    }

    // GET inputInt value on <ESP_IP>/get?inputInt=<inputMessage>
    else if (request->hasParam(PARAM_INT)) {
      inputMessage = request->getParam(PARAM_INT)->value();
      writeFile(SPIFFS, "/inputInt.txt", inputMessage.c_str());
    }
    // GET inputFloat value on <ESP_IP>/get?inputFloat=<inputMessage>
    else if (request->hasParam(PARAM_FLOAT)) {
      inputMessage = request->getParam(PARAM_FLOAT)->value();
      writeFile(SPIFFS, "/inputFloat.txt", inputMessage.c_str());
    }*/
    else {
      inputMessage = "No message sent";
    }
    Serial.println(inputMessage);
    request->send(200, "text/text", inputMessage);
  });
  server.onNotFound(notFound);
  server.begin();
}


String GET_ID_CAIXA()
{
  /*
    // Initialize SPIFFS
  if(!SPIFFS.begin(true)){
    Serial.println("An Error has occurred while mounting SPIFFS");
  }
  */
  return readFile(SPIFFS, "/ID_Caixa.txt");
}
