adolfo-univasf/SensorBeeCounter/(commit log)

2026-01-25 projeto 3D e automato finito feitos
    [Case3D_Sensor-3mm-Corpo.stl, Case3D_Sensor-3mm-Tampa.stl, Case3D_Sensor-3mm.FCStd, Case3D_Sensor-Tampa.stl, Case3D_Sensor.FCStd, Case3D_Sensor.stl, Case3D_Sensor3mm-Emissor5mm-Corpo.stl, Case3d.FCStd]
2026-01-25 exemplo de uso na pasta littlefs falta adaptar para projeto principal
2026-01-31 exemplo de arquivo littleFs e pagina web para download
2026-02-04 funcão salvar implementada, agora ao atingir 1MB cria um arquivo backup e zera o arquivo de dados
2026-02-10 adc funcionando e pagina web mostrando dados atuais
2026-02-11 Adicionado botão para apagar arquivos e ajustar a data e hora com data local do celular
2026-02-14 wifi em modo Access Point (AP) com nome de rede BeeCounter, senha: 12345678 e pagina fixa de 192.168.4.1
    [Arquivo_LittleFS.ino, Display.ino, Main_SensorCaixa.ino, Wifi.ino]
2026-02-15 adicionando o wachtdog time de 6 min para a função salvar dados, caso de falha ele reinicia o microcontrolador
2026-02-17 comunicação lora por parte do sensor
2026-02-21 Gateway requisitando dados do sensor e configuração de wifi facilitada no boot da placa caso botão pressionado
